HexabitzPlatform/H0FR1x-Hardware/README.md

# H0FR1x-Hardware
Hexabitz 230V/10A(RMS) SPDT Relay Module Hardware Design
