HexabitzPlatform/H0FR1x-Hardware/Released/BOM/H0FR1.xlsx

 |  | www.hexabitz.com info@hexabitz.com |  | Bill Of Materials
Customer | Hexabitz | Revision | 1
Project | Hexabitz Modules | Date | 2024-07-18
Board | 230V/10A (RMS) SPDT Relay (H0FR1) | Notes
Designator | Description | Manufacturer Part Number | Manufacturer | Octopart Url | Quantity
X2 | Terminal Block; 17.5 A; 250 V; 5.08 mm; 26 to 14 AWG; 3; Screw; Solder; 4 kV | 1715734 | Phoenix Contact | https://octopart.com/1715734-phoenix+contact-13881?r=sp | 1
RESET | Headers & Wire Housings Unshrouded 1 POS T/H | 5-146280-1 | TE Connectivity | https://octopart.com/5-146280-1-te+connectivity+%2F+amp-40259676?r=sp | 1
SWD | Conn Unshrouded Header HDR 3 POS 2.54mm Solder ST Top Entry Thru-Hole Carton | 5-146281-3 | TE Connectivity | https://octopart.com/5-146281-3-te+connectivity+%2F+amp-39745942?r=sp | 1
R7 | RES SMD 0.0OHM JUMPER 1/10W 0603 | RC0603JR-070RL | YAGEO [VR] | https://octopart.com/rc0603jr-070rl-yageo-1241539?r=sp | 1
R2 | RES 180 Ohms 5% 1/10W 0603 | 0603WAJ0181T5E | ROYAL OHM | https://octopart.com/0603waj0181t5e-royal+ohm-127861182?r=sp | 1
R9 , R10 | RES 150 OHM 1% 1/4W 0603 | 1-2176326-5 | TE Connectivity | https://octopart.com/1-2176326-5-te+connectivity-91016741?r=sp | 2
R1 | Thick Film Resistors - SMD 0603 270 Ohm 5% Tol | ERJ-3GEYJ271V | Panasonic | https://octopart.com/erj-3geyj271v-panasonic-55560546?r=sp | 1
R3 , R8 | RES 10K Ohm 1% 0603 | RC0603FR-0710KL | Yageo | https://octopart.com/rc0603fr-0710kl-yageo-40025538?r=sp | 2
C3, C5, C6, C8 | CAP CER 0.1UF 25V X7R 0603 | CGA3E2X8R1E104K080AE | TDK | https://octopart.com/cga3e2x8r1e104k080ae-tdk-68305753?r=sp | 4
C1 | CAP CER 1 UF 16V X7R 0805 | CC0805KKX7R7BB105 | YAGEO [VA] | https://octopart.com/cc0805kkx7r7bb105-yageo-8376555?r=sp | 1
C4 | CAP CER 4.7UF 16V X7R 0805 | C0805C475K4RACTU | KEMET [VA] | https://octopart.com/c0805c475k4ractu-kemet-22859922?r=sp | 1
FB1 | Ind chip Bead Multi-Layer 30 ohms 25% 100MHZ Ferrite 1,5A 0603Punched paper T/R | MMZ1608Y300BTA00 | TDK | https://octopart.com/mmz1608y300bta00-tdk-7906990?r=sp | 1
D1 | LED Uni-Color Super Red 639nm 2-Pin Chip 0603(1608Metric) T/R | VLMS1300-GS08 | Vishay | https://octopart.com/vlms1300-gs08-vishay-21709201?r=sp | 1
D2 | LED Uni-Color Soft Orange 611nm 2-Pin Chip 0603(1608Metric) T/R | VLMO1300-GS08 | Vishay | https://octopart.com/vlmo1300-gs08-vishay-21709200?r=sp | 1
D5 | TVS DIODE 3,3V 10,9V SOD323 | CDSOD323-T03SC | BOURNS INC | https://octopart.com/cdsod323-t03sc-bourns-10487153?r=sp | 1
D3 | Rectifier Diode, Schottky, 1 Phase, 1 Element, 0.3A, 40V V(RRM), Silicon | BAT54JFILM | STMicroelectronics | https://octopart.com/bat54jfilm-stmicroelectronics-326073?r=sp | 1
Q2 | Transistor MOSFET Negative Channel 100 Volt 0.17A 3-Pin SOT-23 | BSS123 | onsemi | https://octopart.com/bss123-onsemi-20837328?r=sp | 1
U1 | MCU 32-bit ARM Cortex M0+ RISC 512KB Flash 1.8V/2.5V/3.3V 48-Pin UFQFPN EP Tray | STM32G0B1CEU6 | STMicroelectronics | https://octopart.com/stm32g0b1ceu6-stmicroelectronics-116363364?r=sp | 1
U2 | Power Relay 3VDC 8DC/10AAC SPDT (22.5mm 16.5mm 19mm) THT | G5LE-14 DC3 | Omron | https://octopart.com/g5le-14-dc3-omron-6508769?r=sp&s=6I6RsLueSo2S2OmQXlG-5Q | 1
X1 | 8,0000MHZ 33pF SMD MURATA Resonators | CSTNE8M00G550000R0 | Murata | https://octopart.com/cstne8m00g550000r0-murata-91406934?r=sp | 1
