HexabitzPlatform/H0FR1x-Hardware/Documentation/H0FR1 Schematics.pdf

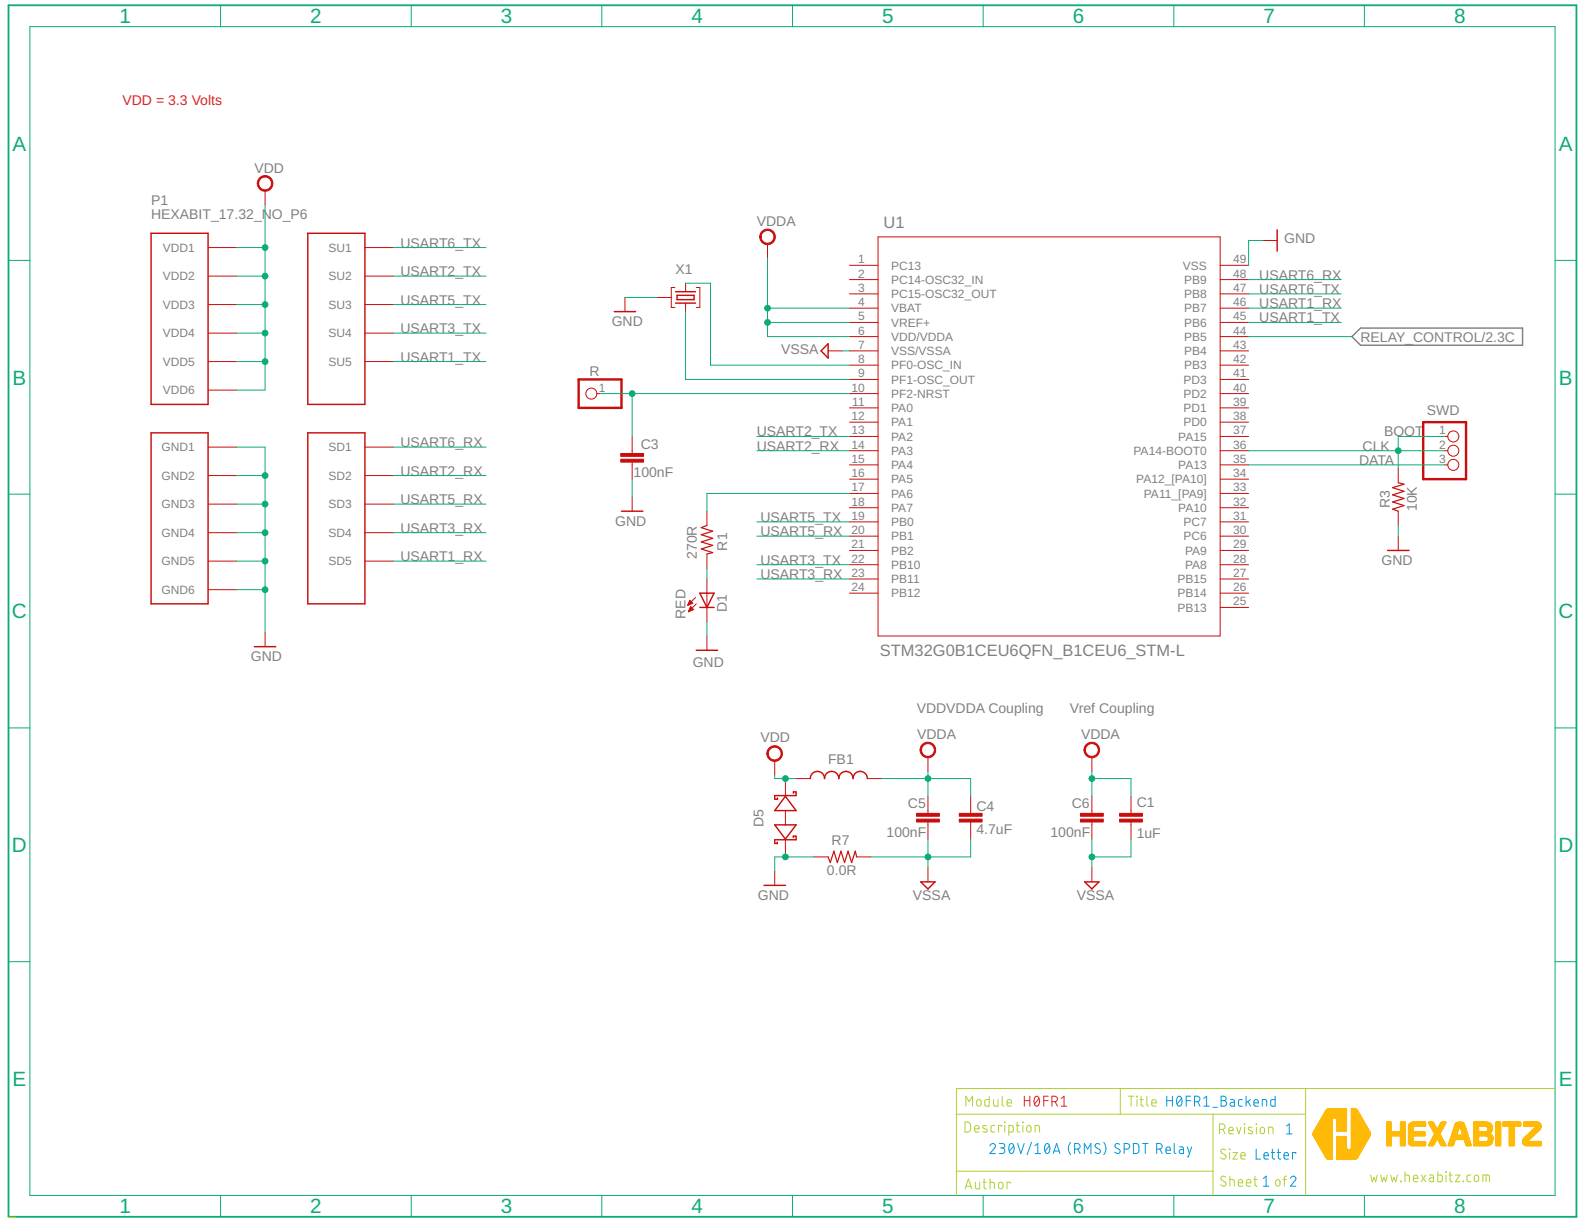
[picture p1: page 1]

35 PA14-BOOT0 DATA
32 PA11_[PA9] 33 PA12_[PA10] 34 PA13

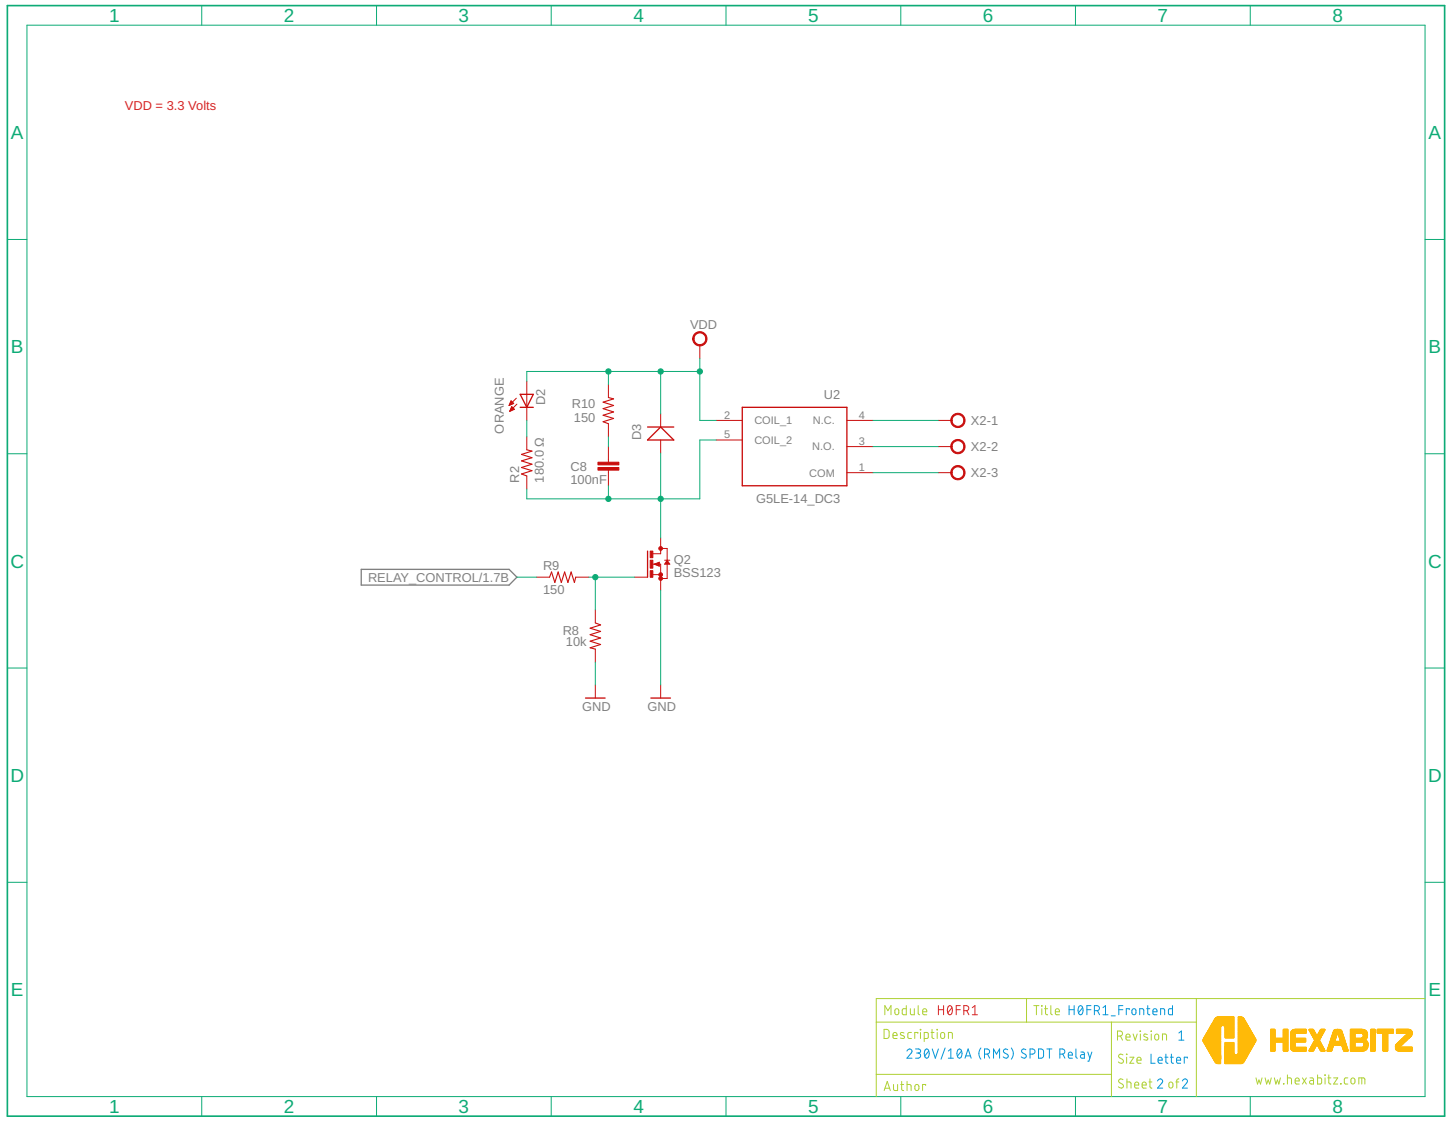
[picture p2: page 2]
