HexabitzPlatform/H0FR1x-Hardware/Design/H0FR1.brd

## EAGLE design Design/H0FR1.brd (2024-09-10)

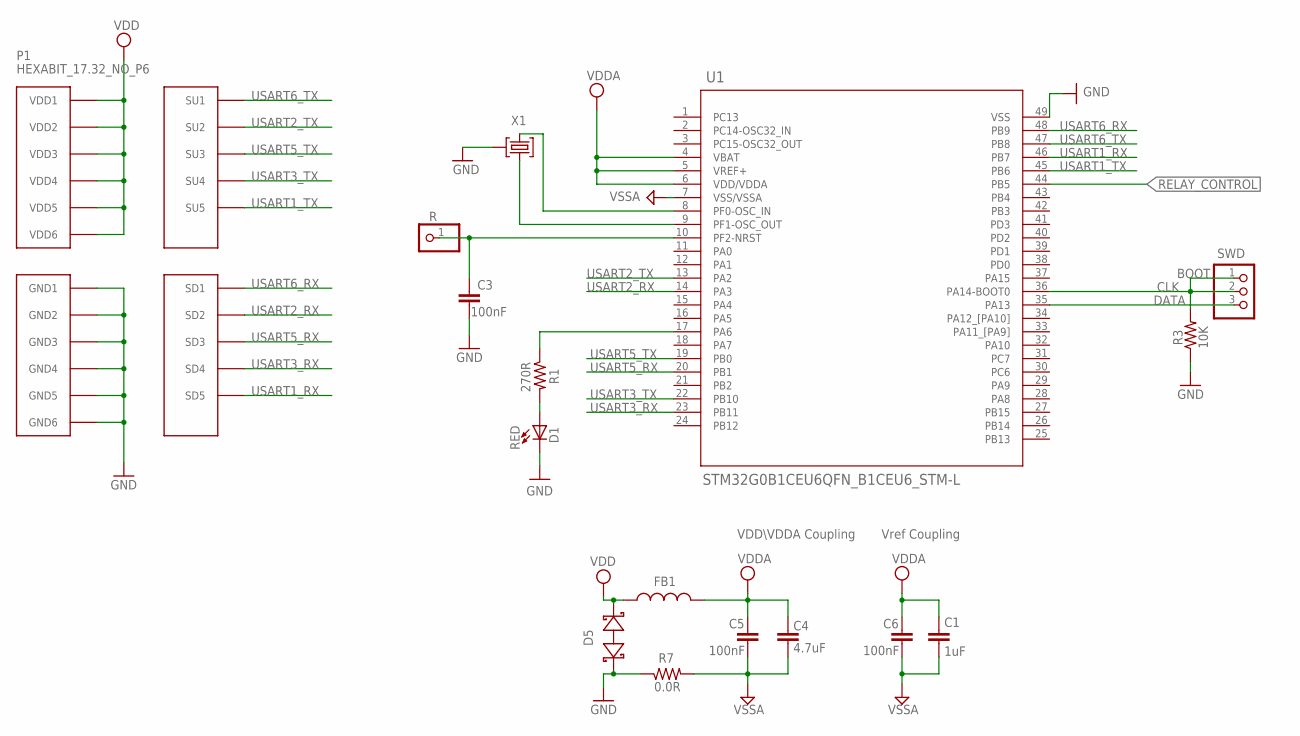
[picture p3: schematic H0FR1.sch, sheet 1]

Parts:
C1: 1uF; C-0805
C3, C5, C6: 100nF; C-0603
C4: 4.7uF; C-0805
D1: RED; VLMS1300-GS08; MPN VLMS1300-GS08
D5: BOURNS_CDSOD323-T03SCBOURNS_CDSOD323-T03SC_0_0; BOURNS_CDSOD323-T03SC_0
FB1: FB-TDK_MMZ1608Y300B; FB-0603; MPN MMZ1608Y300B
P1: HEXABIT_17.32_NO_P6
R: R; 1X01
R1: 270R; R-0603
R3: 10K; R-0603
R7: 0.0R; R-0603; MPN RC0603JR-070RL
SWD: PINHD-1X3; 1X03
TRIMBLE-LOGO1: HEXA-LOGO
U1: STM32G0B1CEU6QFN_B1CEU6_STM-L; QFN_B1CEU6_STM-L
X1: XTALL_CSTCE8M00G52

Connections:
CLK: R3.2, SWD.1, SWD.2, U1.36 (PA14-BOOT0)
DATA: SWD.3, U1.35 (PA13)
GND: C3.2, D1.C, D5.1 (A), P1.PAD_PD7 (GND1), P1.PAD_PD8 (GND2), P1.PAD_PD9 (GND3), P1.PAD_PD10 (GND4), P1.PAD_PD11 (GND5), P1.PAD_PD12 (GND6), R3.1, R7.1, U1.49 (VSS), X1.P$2 (2); also elsewhere on the board
unnamed: D1.A, R1.2
unnamed: R1.1, U1.17 (PA6)
unnamed: C3.1, R.1, U1.10 (PF2-NRST)
unnamed: U1.9 (PF1-OSC_OUT), X1.P$1 (1)
unnamed: U1.8 (PF0-OSC_IN), X1.P$3 (3)
RELAY_CONTROL: U1.44 (PB5); also elsewhere on the board
USART1_RX: P1.PAD_PD5 (SD5), U1.46 (PB7)
USART1_TX: P1.PAD_PU5 (SU5), U1.45 (PB6)
USART2_RX: P1.PAD_PD2 (SD2), U1.14 (PA3)
USART2_TX: P1.PAD_PU2 (SU2), U1.13 (PA2)
USART3_RX: P1.PAD_PD4 (SD4), U1.23 (PB11)
USART3_TX: P1.PAD_PU4 (SU4), U1.22 (PB10)
USART5_RX: P1.PAD_PD3 (SD3), U1.20 (PB1)
USART5_TX: P1.PAD_PU3 (SU3), U1.19 (PB0)
USART6_RX: P1.PAD_PD1 (SD1), U1.48 (PB9)
USART6_TX: P1.PAD_PU1 (SU1), U1.47 (PB8)
VDD: D5.2 (C), FB1.2, P1.PAD_PU7 (VDD1), P1.PAD_PU8 (VDD2), P1.PAD_PU9 (VDD3), P1.PAD_PU10 (VDD4), P1.PAD_PU11 (VDD5), P1.PAD_PU12 (VDD6); also elsewhere on the board
VDDA: C1.1, C4.1, C5.1, C6.1, FB1.1, U1.4 (VBAT), U1.5 (VREF+), U1.6 (VDD/VDDA)
VSSA: C1.2, C4.2, C5.2, C6.2, R7.2, U1.7 (VSS/VSSA)

Notes on the sheet:
Vref Coupling
VDD\VDDA Coupling
BOOT

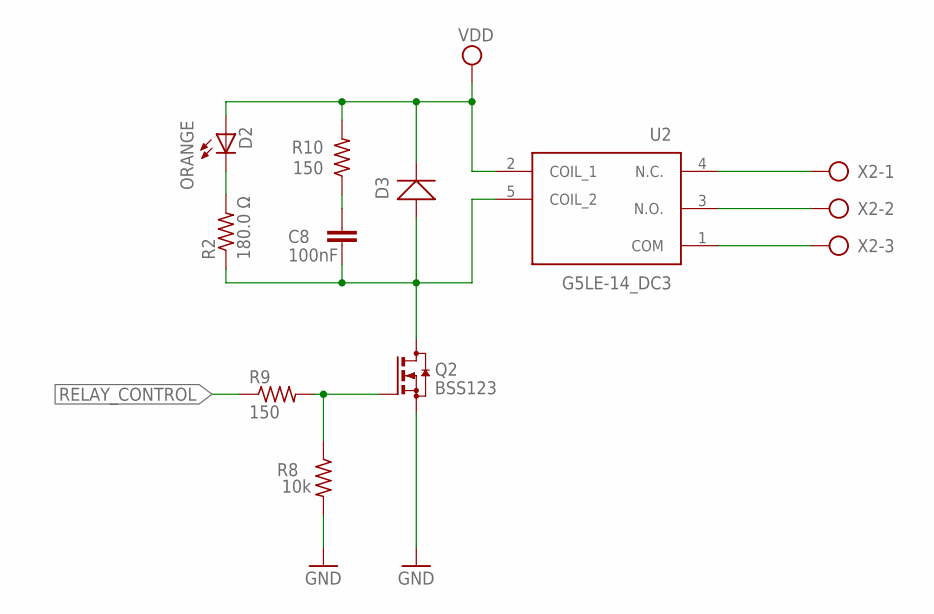
[picture p4: schematic H0FR1.sch, sheet 2]

Parts:
C8: 100nF; C-0603; TOLERANCE 10%; VOLTAGE_RATING 10V; MPN C0603C104K8RACTU
D2: orange; VLMS1300-GS08; MPN VLMY1300-GS08
D3: 40V 300MA; SOD-323
Q2: BSS123; SOT23
R2: 180.0 Ω; R-0603; TOLERANCE ±5%; MPN ERJ-3GEYJ181V
R8: 10k; R-0603; TOLERANCE 5%; MPN RC0603JR-07680KL
R9: 150; R-0603; TOLERANCE ±5%; MPN CRCW06031K00JNEA
R10: 150; R-0603; TOLERANCE 5%; MPN RC0603JR-07680KL
U2: G5LE-14_DC3; G5LE-14_SPDT
X2: AK300/3

Connections:
COM: U2.1 (COM), X2.3
GND: Q2.2 (S), R8.2; also elsewhere on the board
unnamed: C8.2, D3.+, Q2.3 (D), R2.1, U2.5 (COIL_2)
unnamed: D2.C, R2.2
unnamed: Q2.1 (G), R8.1, R9.2
unnamed: C8.1, R10.1
NC: U2.4 (N.C.), X2.1
NO: U2.3 (N.O.), X2.2
RELAY_CONTROL: R9.1; also elsewhere on the board
VDD: D2.A, D3.-, R10.2, U2.2 (COIL_1); also elsewhere on the board

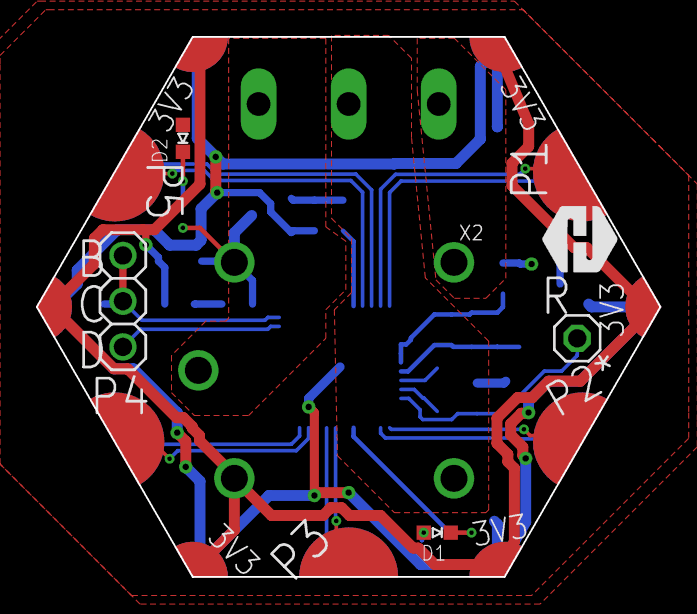
[picture p5: board Design/H0FR1.brd from above]

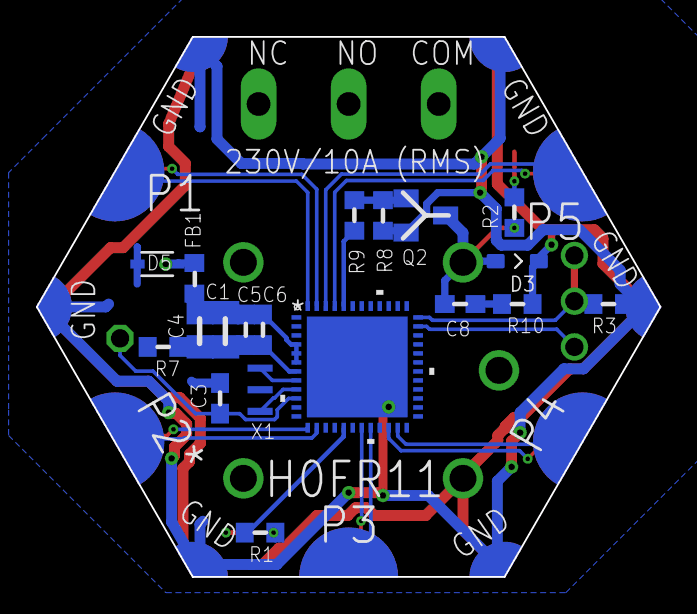
[picture p6: board Design/H0FR1.brd from below]

Board: 2 copper layers, 34.6 x 30.0 mm, 27 parts (19 on the bottom side), 29 nets.
