HexabitzPlatform/H0FR1x-Hardware/H0FR1/Design/H0FR1.brd

## EAGLE design H0FR1/Design/H0FR1.brd (2024-06-21, an earlier design)

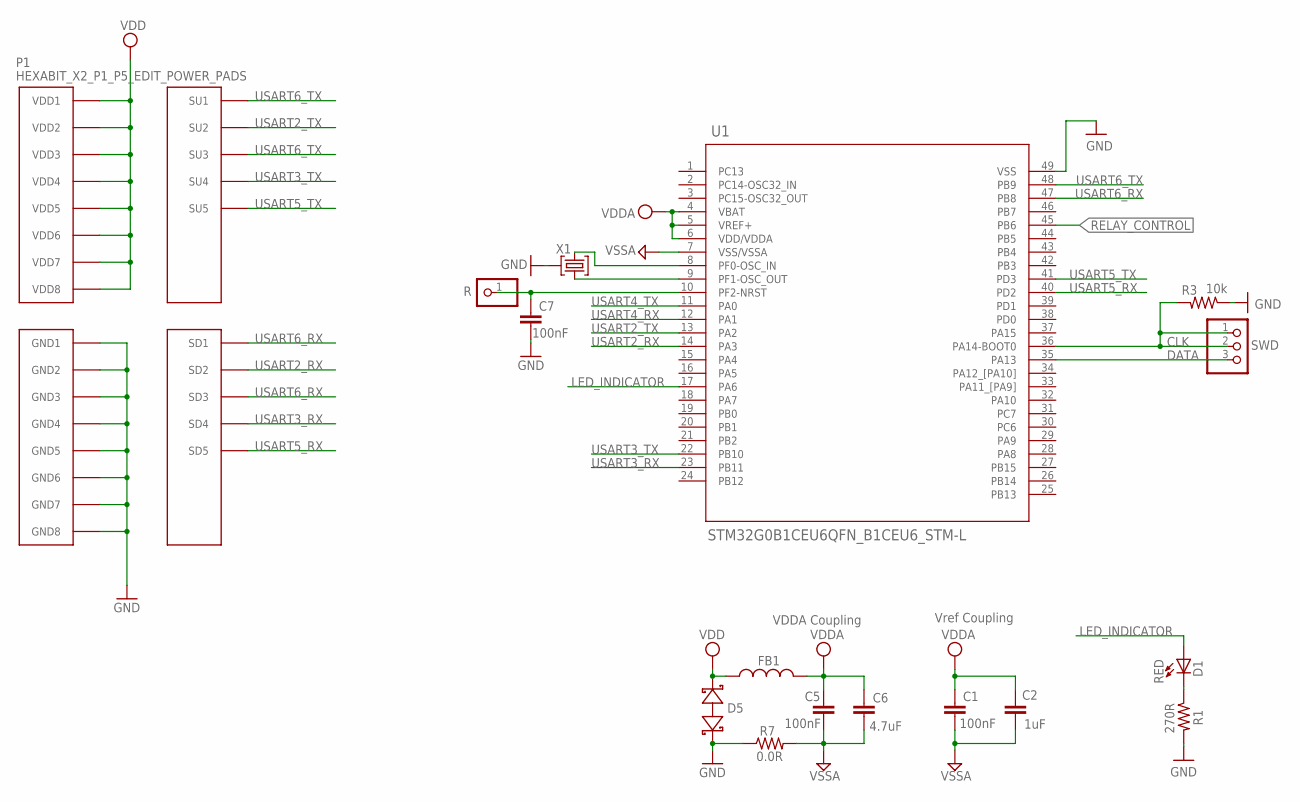
[picture p7: schematic H0FR1.sch, sheet 1]

Parts:
C1: 100nF; C-0603; TOLERANCE 10%; VOLTAGE_RATING 10V; MPN C0603C104K8RACTU
C2: 1uF; C-0805; TOLERANCE 10%; VOLTAGE_RATING 16V; MPN CC0805KKX7R7BB105
C5, C7: 100nF; C-0603
C6: 4.7uF; C-0805; TOLERANCE 10%; VOLTAGE_RATING 25V; MPN GRM21BC81E475KA12L
D1: RED; VLMS1300-GS08; MPN VLMS1300-GS08
D5: BOURNS_CDSOD323-T03SCBOURNS_CDSOD323-T03SC_0_0; BOURNS_CDSOD323-T03SC_0
FB1: FB-0603
P1: HEXABIT_X2_P1_P5_EDIT_POWER_PADS
R: R; 1X01
R1: 270R; R-0603
R3: 10k; R-0603; TOLERANCE 5%; MPN RC0603JR-0710KL
R7: 0.0R; R-0603
SWD: PINHD-1X3SWD; SWD
TRIMBLE-LOGO2: HEXA-LOGO
U1: STM32G0B1CEU6QFN_B1CEU6_STM-L; QFN_B1CEU6_STM-L
X1: XTALL_CSTCE8M00G52

Connections:
CLK: R3.2, SWD.1, SWD.2, U1.36 (PA14-BOOT0)
DATA: SWD.3, U1.35 (PA13)
GND: C7.2, D5.2 (C), P1.PAD_PD11 (GND1), P1.PAD_PD12 (GND2), P1.PAD_PD13 (GND3), P1.PAD_PD14 (GND4), P1.PAD_PD17 (GND5), P1.PAD_PD18 (GND6), P1.PAD_PD19 (GND7), P1.PAD_PD20 (GND8), R1.2, R3.1, R7.1, U1.49 (VSS), X1.P$2 (2); also elsewhere on the board
LED_INDICATOR: D1.A, U1.17 (PA6)
unnamed: D1.C, R1.1
unnamed: C7.1, R.1, U1.10 (PF2-NRST)
unnamed: U1.9 (PF1-OSC_OUT), X1.P$1 (1)
unnamed: U1.8 (PF0-OSC_IN), X1.P$3 (3)
RELAY_CONTROL: U1.45 (PB6); also elsewhere on the board
USART2_RX: P1.PAD_PD2 (SD2), U1.14 (PA3)
USART2_TX: P1.PAD_PU2 (SU2), U1.13 (PA2)
USART3_RX: P1.PAD_PD4 (SD4), U1.23 (PB11)
USART3_TX: P1.PAD_PU4 (SU4), U1.22 (PB10)
USART4_RX: U1.12 (PA1)
USART4_TX: U1.11 (PA0)
USART5_RX: P1.PAD_PD5 (SD5), U1.40 (PD2)
USART5_TX: P1.PAD_PU5 (SU5), U1.41 (PD3)
USART6_RX: P1.PAD_PD1 (SD1), P1.PAD_PD3 (SD3), U1.47 (PB8)
USART6_TX: P1.PAD_PU1 (SU1), P1.PAD_PU3 (SU3), U1.48 (PB9)
VDD: D5.1 (A), FB1.1, P1.PAD_PU11 (VDD1), P1.PAD_PU12 (VDD2), P1.PAD_PU13 (VDD3), P1.PAD_PU14 (VDD4), P1.PAD_PU17 (VDD5), P1.PAD_PU18 (VDD6), P1.PAD_PU19 (VDD7), P1.PAD_PU20 (VDD8); also elsewhere on the board
VDDA: C1.1, C2.1, C5.1, C6.1, FB1.2, U1.4 (VBAT), U1.5 (VREF+), U1.6 (VDD/VDDA)
VSSA: C1.2, C2.2, C5.2, C6.2, R7.2, U1.7 (VSS/VSSA)

Notes on the sheet:
Vref Coupling
VDDA Coupling

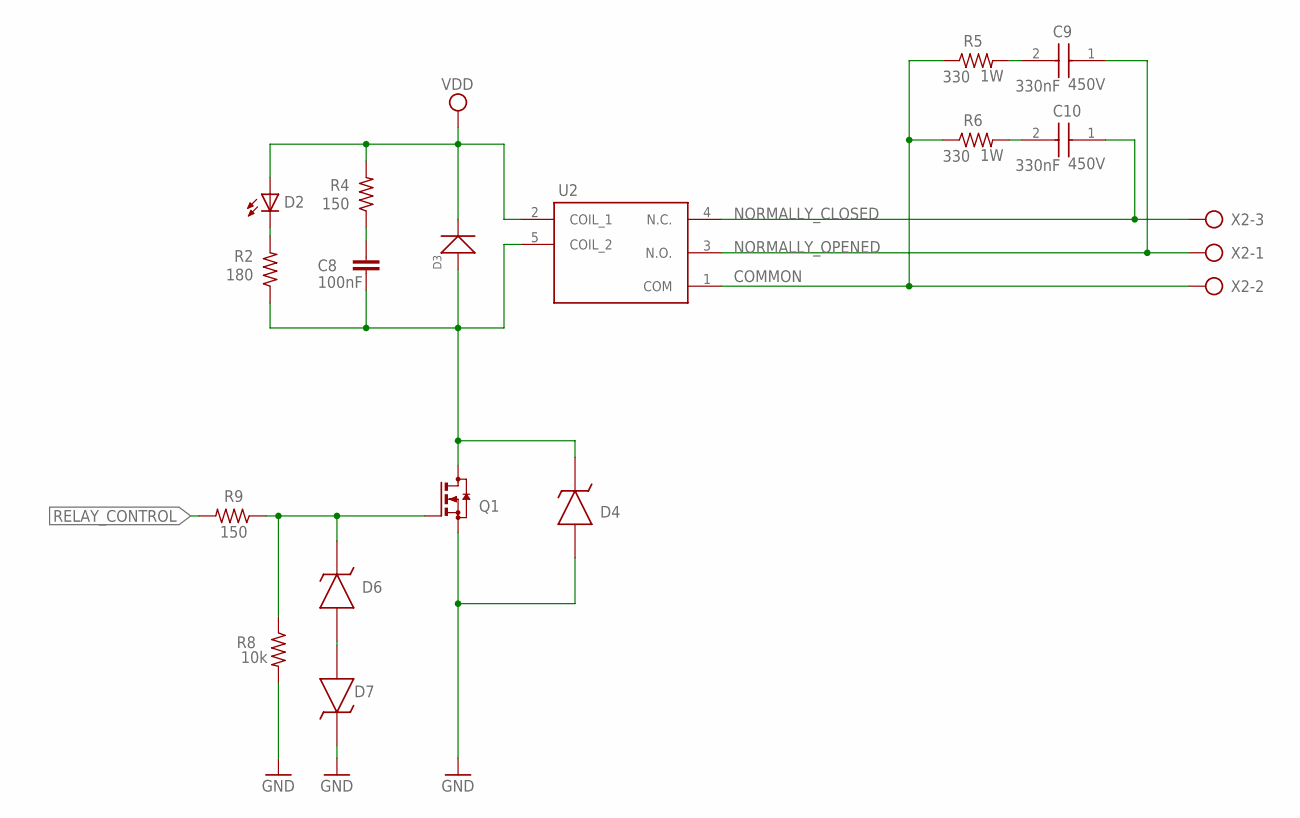
[picture p8: schematic H0FR1.sch, sheet 2]

Parts:
C8: 100nF; C-0603; TOLERANCE 10%; VOLTAGE_RATING 10V; MPN C0603C104K8RACTU
C9, C10: 330nF; B32922Q_(18_X_8.5)
D2: RED; VLMS1300-GS08; MPN VLMY1300-GS08
D3: 40V 300MA; SOD-323
D4, D6, D7: MMSZ4705T1GMMSZ4705T1G; DIO_MMSZ4700T1G
Q1: BSS123; SOT23
R2: 180; R-0603; TOLERANCE ±5%; MPN ERJ-3GEYJ181V
R4, R9: 150; R-0603; TOLERANCE 5%; MPN RC0603JR-07680KL
R5, R6: 330; R2512; MPN RMCF2512JT330R
R8: 10k; R-0603; TOLERANCE 5%; MPN RC0603JR-07680KL
U2: G5LE-14_DC3; G5LE-14_SPDT
X2: AK300/3

Connections:
COMMON: R5.1, R6.1, U2.1 (COM), X2.2
GND: D4.A, D7.K, Q1.2 (S), R8.2; also elsewhere on the board
unnamed: D6.A, D7.A
unnamed: D6.K, Q1.1 (G), R8.1, R9.1
unnamed: D2.C, R2.2
unnamed: C9.2, R5.2
unnamed: C8.1, R4.1
unnamed: C10.2, R6.2
unnamed: C8.2, D3.+, D4.K, Q1.3 (D), R2.1, U2.5 (COIL_2)
NORMALLY_CLOSED: C10.1, U2.4 (N.C.), X2.3
NORMALLY_OPENED: C9.1, U2.3 (N.O.), X2.1
RELAY_CONTROL: R9.2; also elsewhere on the board
VDD: D2.A, D3.-, R4.2, U2.2 (COIL_1); also elsewhere on the board

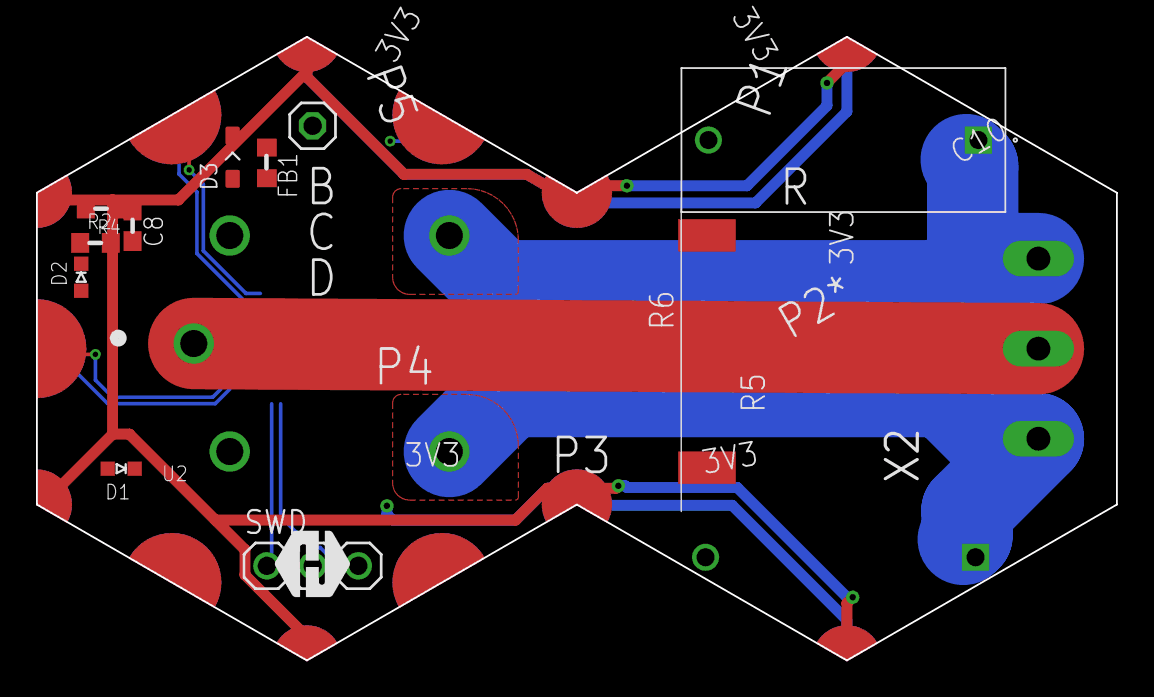
[picture p9: board H0FR1/Design/H0FR1.brd from above]

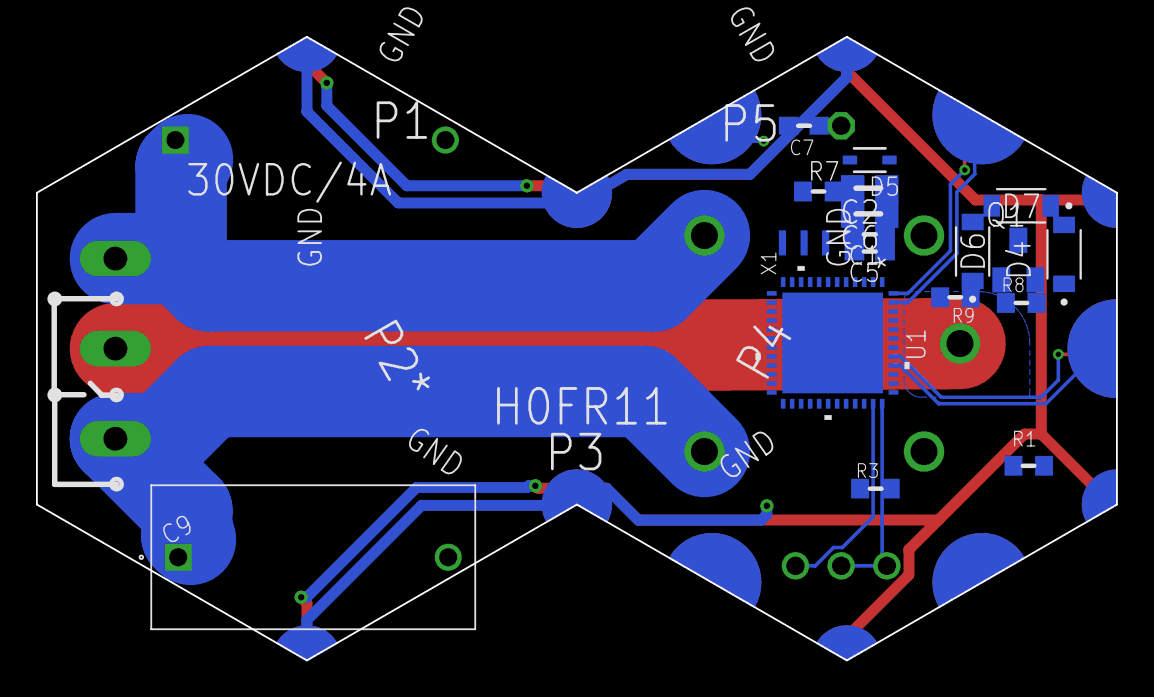
[picture p10: board H0FR1/Design/H0FR1.brd from below]

Board: 2 copper layers, 60.0 x 34.6 mm, 34 parts (18 on the bottom side), 30 nets.
