HexabitzPlatform/H0FR1x-Hardware/(commit log)

2019-06-02 Adding design and release rev 0 files
    [H0FR10.brd, H0FR10.sch, H0FR10.xlsx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]
2019-06-05 Adding git ignore
    Moving files into folder
    [H0FR10.brd, H0FR10.sch, H0FR10.xlsx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]
2019-07-01 Fixed R2 PN
    [H0FR10.brd, H0FR10.sch, H0FR10.xlsx]
2019-08-06 Update H0FR10.xlsx
    Update & fix some BOM entries
    [H0FR10.xlsx]
2020-04-08 editing notes & descriptions (3oz to 2oz & 10A to 8A)
    [H0FR10.brd, H0FR10.sch]
2020-06-10 change base resistor(R4) from 2k4 to 1k0 Schematic & BOM was changed
    [H0FR10.sch, H0FR10.xlsx]
2020-06-15 Fix ERC errors Generate PDF Release at V0 again
    [H0FR10.brd, H0FR10.sch]
2021-04-27 - Changed to Rev1; this revision is 1OZ /4AMP..
    [H0FR11.brd, H0FR11.sch, H0FR11.xlsx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]
2024-03-10 Not finished yet.... -Changing the MCU to STM32G0B1CEU6N -Improving the layout design
    [H0FR.xlsx, H0FR1.brd, H0FR1.sch, H0FR11.brd, H0FR11.sch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]
2024-05-30 Design modification
    [H0FR.xlsx, H0FR1.brd, H0FR1.sch]
2024-05-31 Schematic modification
    [H0FR1.brd, H0FR1.sch]
2024-06-01 Edit the decription
    [H0FR1.sch]
2024-06-21 Intial parts placing on the board
    [H0FR1.brd, H0FR1.sch]
2024-07-19 All finish, reviewed version
    [H0FR.xlsx, H0FR1.brd, H0FR1.sch, H0FR1.xlsx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]
2024-09-10 -Fixing an issue on the silkscreen layer
    [H0FR1.brd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]
